sgmne/AnalogKeypad/TwoWireKeypad.pdf

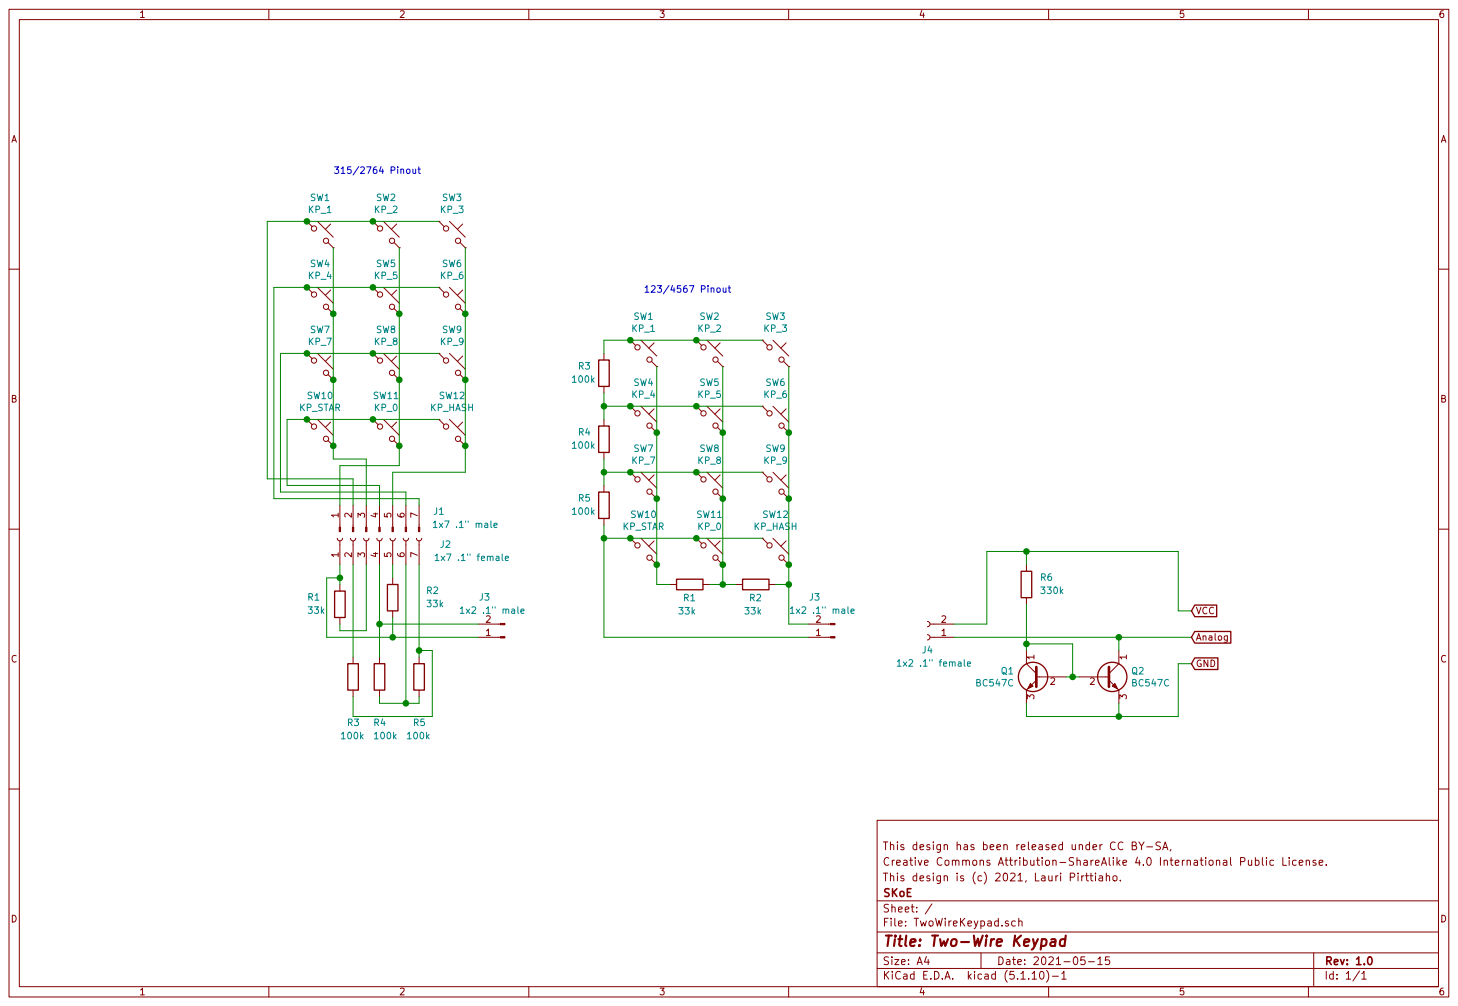
[picture p2: page 1]

This design is (c) 2021, Lauri Pirttiaho. Creative Commons Attribution-ShareAlike 4.0 International Public License. This design has been released under CC BY-SA, 1

File: TwoWireKeypad.sch Sheet: / SKoE

Id: 1/1 Title: Two-Wire Keypad
