sgmne/AnalogKeypad/(threads)

Thread 1 (2021-06-10):

circuit suggestions...

sbridger, 2021-06-10:
You might well know these, but anyway...

Use a pnp mirror, then the kbd is grounded, which makes emc/filtering and static discharge resistance easier to manage.
(also means that VCC is not going to kbd , so kbd-gnd shorts are current limited by the current mirror)

If you measure the V(Q1b) you can correct for variable Vcc and Vbe(temp) and get a true ratio. i.e. Ratio= Nadc.vbe / Nadc.kbd

Alternatively, and better , is to connect Vref+ to Q1be (pnp) , and then the adc value is a true R value completely compensated for VCC and temperature changes, with no software effort.  [depends on whether adc ref pin draws significant current]

sgmne, 2021-06-11:
Thanks Sbridger!

Both of the emc/static and the more safer handling of shorting the keypad or its wiring to ground are excellent improvements. I did not think of them when comparing low and high side current mirrors.

When comparing PNP and NPN current mirrors, typically NPN is more linear. As an example, a design with BCV61C (NPN) and BCV62C (PNP) but otherwise identical (150Ω at measuring side emitter, 150 kΩ at reference, and 3x4 keypad with 12 kΩ spacing) the droop in the middle is 80 mV for NPN but 140 mV for PNP (LTSpice simulation, Infineon models for BCV6xC). In that case this is likely not an issue though, and I think the benefits of the high-side current mirror may be more important in many practical applications.

Measuring the base voltage or using it as a reference and using those for temperature compensation I thought of. That is a trade-off of another pin from the microcotroller vs. the emitter resisitor. The same applies to feeding the base voltage to the ADC Vref, but that requires, besides the second pin of the microcontroller, also an additional series resistor for the keypad to distinguish the no-key-pressed case. In some cases those may still be worth considering, so it is good to keep them in mind.

Thread 2 (2021-12-11):

Thank you for the suggestion.

cutephoton, 2021-12-11:
I mostly wanted to thank you for posting this & the video. Thinking in the current domain like this is like trying to write with my left hand. I don't have the muscle memory nor intuition to use it. I design hardware as a hobbyist, but professionally I am a (bored) embedded systems engineer. As I come from a digital domain, discreet analog circuits tend to be more challenging.

This is exactly the kind of project that makes trying something different fun and educational. It was simple, easy to understand, practical, and (bonus) firmware is simplified. Current mirrors tend to be discussed in more formal ways with lots of text, equations and toy circuits that do nothing useful... it's so much easier to appreciate when the application is real. I hope to see more from you in the future. :) Thank you.

And so behold... this is an unintentionally small 4x4 single sided keypad test fixture. I'm thinking of adopting this technique in a project that uses low pin count (8 pin) ATTiny devices to handle user input and WS2812-style RGB leds. I mostly wanted something I can just drop in to other projects instead of re-implementing these basic building blocks every time I design something.

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

sgmne, 2021-12-13:
Looks like a nice layout. Thanks for sharing! With one pin for keypad and 5 pins for up to 20 LEDs using Charlieplexing something quite spectacular can be made. Have fun!
