sgmne/AnalogKeypad/(commit log)

2021-05-16 Add schematic and Ardino demo code
2021-05-16 Added missing component ID to schematic
